mpaunete/rolo/electronics/rolo.step

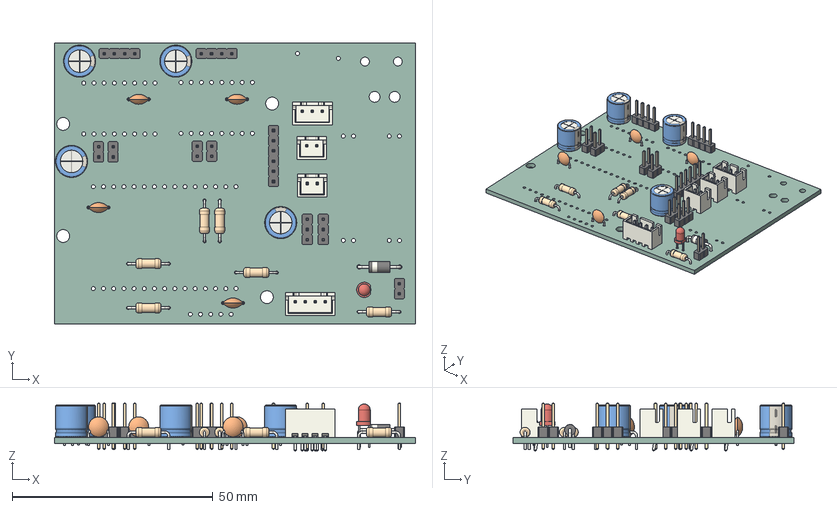
[picture p5: CAD file, 2026-10-27]
electronics/rolo.step
90.0 x 70.0 x 11.9 mm
R_Axial_DIN0207_L63mm_D25mm_P1016mm_Horizontal x 6
C_Disc_D50mm_W25mm_P500mm x 4
PinHeader_1x04_P254mm_Vertical x 2
JST_B2B_XH_A x 2
PinHeader_1x03_P254mm_Vertical x 2
CP_Radial_D80mm_P350mm x 4
JST_B4B_XH_A
PinHeader_1x02_P254mm_Vertical x 5
LED_D3.0mm
PinHeader_1x06_P254mm_Vertical
JST_B3B_XH_A
D_DO-41_SOD81_P10.16mm_Horizontal
rolo-unsaved-export-d1h4hm_PCB
