mpaunete/rolo/electronics/rolo.kicad_pcb

## KiCad design electronics/rolo.kicad_pcb (2026-10-27)

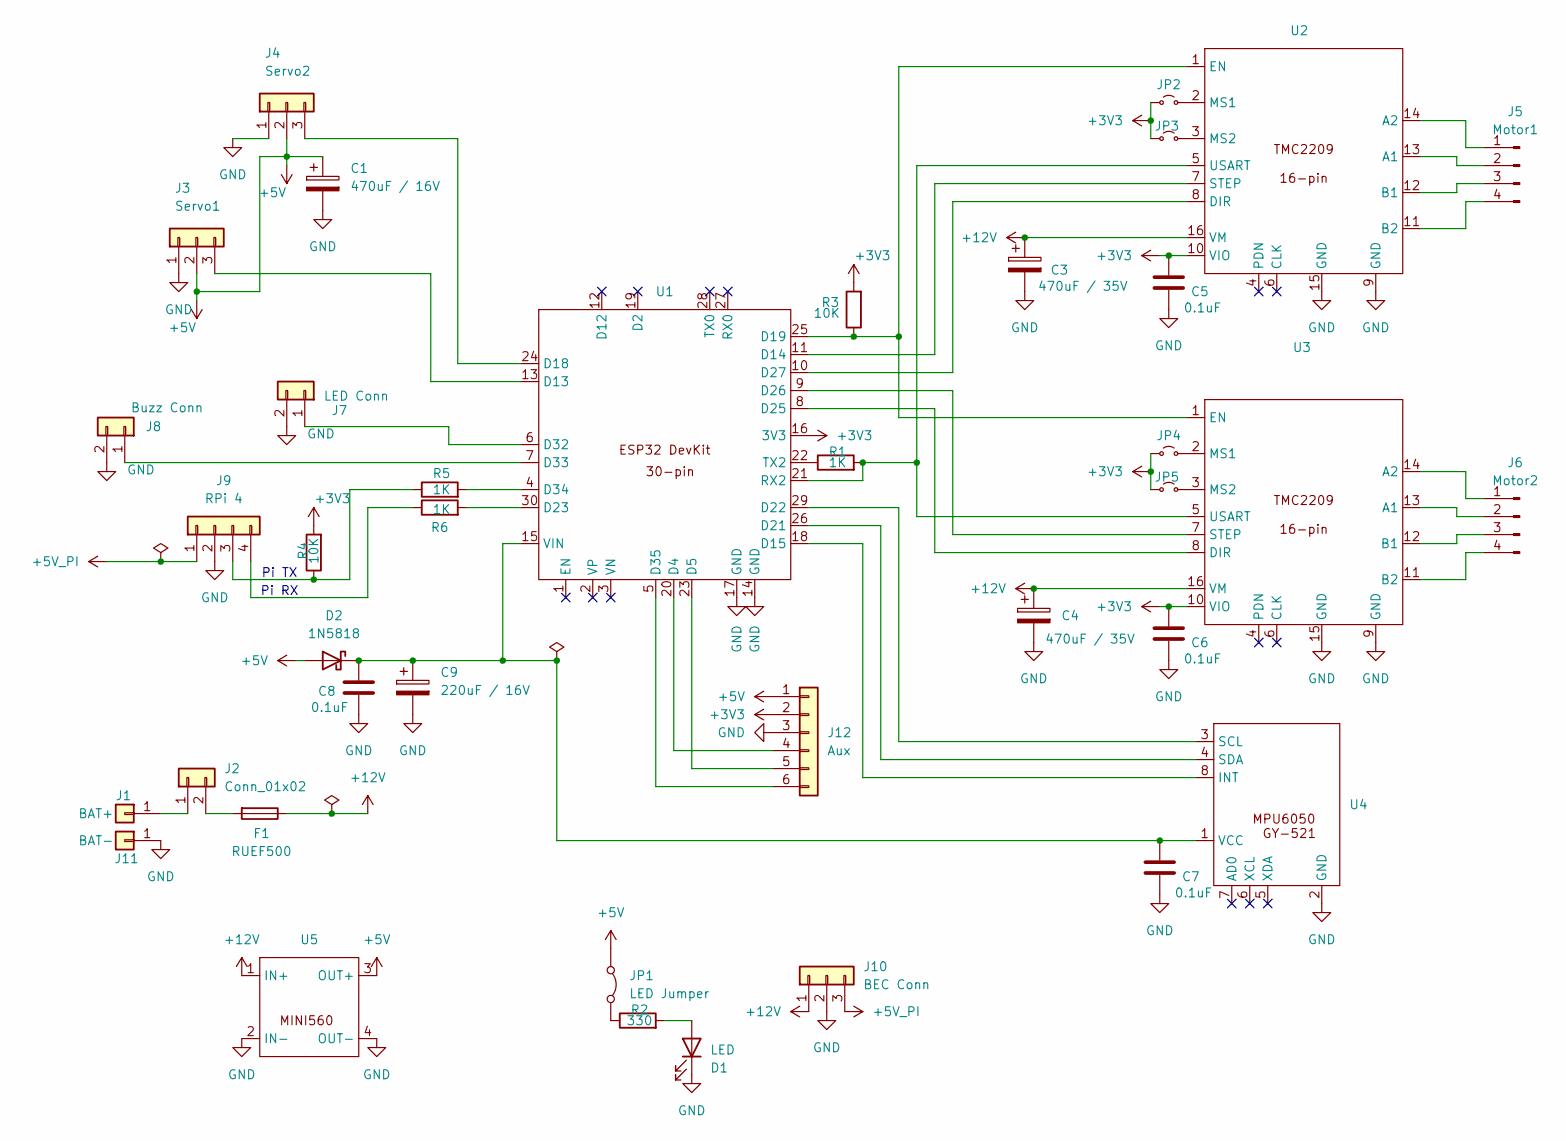
[picture p7: schematic rolo.kicad_sch]

Parts:
C1: 470uF / 16V; CP_Radial_D8.0mm_P3.50mm
C3, C4: 470uF / 35V; CP_Radial_D8.0mm_P3.50mm
C5, C6, C7, C8: 0.1uF; C_Disc_D5.0mm_W2.5mm_P5.00mm
C9: 220uF / 16V; CP_Radial_D8.0mm_P3.50mm
D1: LED; LED_D3.0mm
D2: 1N5818; D_DO-41_SOD81_P10.16mm_Horizontal
F1: RUEF500; Fuse_RUEF500
J1: BAT+; MountingHole_2.2mm_M2_Pad
J2: Conn_01x02; AMASS_XT30U-M_1x02_P5.0mm_Vertical
J3: Servo1; PinHeader_1x03_P2.54mm_Vertical
J4: Servo2; PinHeader_1x03_P2.54mm_Vertical
J5: Motor1; PinHeader_1x04_P2.54mm_Vertical
J6: Motor2; PinHeader_1x04_P2.54mm_Vertical
J7: LED Conn; JST_XH_B2B-XH-A_1x02_P2.50mm_Vertical
J8: Buzz Conn; JST_XH_B2B-XH-A_1x02_P2.50mm_Vertical
J9: RPi 4; JST_XH_B4B-XH-A_1x04_P2.50mm_Vertical
J10: BEC Conn; JST_XH_B3B-XH-A_1x03_P2.50mm_Vertical
J11: BAT-; MountingHole_2.2mm_M2_Pad
J12: Aux; PinHeader_1x06_P2.54mm_Vertical
JP1: LED Jumper; PinHeader_1x02_P2.54mm_Vertical
JP2, JP4: MS1 EN; PinHeader_1x02_P2.54mm_Vertical
JP3, JP5: MS2 EN; PinHeader_1x02_P2.54mm_Vertical
R1, R5, R6: 1K; R_Axial_DIN0207_L6.3mm_D2.5mm_P10.16mm_Horizontal
R2: 330; R_Axial_DIN0207_L6.3mm_D2.5mm_P10.16mm_Horizontal
R3, R4: 10K; R_Axial_DIN0207_L6.3mm_D2.5mm_P10.16mm_Horizontal
U1: ESP32_DevKit_30Pin
U2, U3: TMC2209_16Pin
U4: MPU6050_Conn
U5: MINI560_5V_8Pin

Connections:
+3V3: C5.1, C6.1, J12.2, JP2.1 (A), JP3.1 (A), JP4.1 (A), JP5.1 (A), R3.2, R4.2, U1.16 (3V3), U2.10 (VIO), U3.10 (VIO)
+5V: C1.1, D2.2 (A), J3.2, J4.2, J12.1, JP1.1 (A), U5.3 (OUT+)
+5V_PI: J9.1, J10.3
+12V: C3.1, C4.1, F1.1, J10.1, U2.16 (VM), U3.16 (VM), U5.1 (IN+)
GND: C1.2, C3.2, C4.2, C5.2, C6.2, C7.2, C8.2, C9.2, D1.1 (K), J3.1, J4.1, J7.2, J8.2, J9.2, J10.2, J11.1 (Pin_1_1), J12.3, U1.14 (GND), U1.17 (GND), U2.9 (GND), U2.15 (GND), U3.9 (GND), U3.15 (GND), U4.2 (GND), U5.2 (IN-), U5.4 (OUT-)
unnamed: D1.2 (A), R2.2
unnamed: C7.1, C8.1, C9.1, D2.1 (K), U1.15 (VIN), U4.1 (VCC)
unnamed: J1.1 (Pin_1_1), J2.1
unnamed: F1.2, J2.2
unnamed: J3.3, U1.13 (D13)
unnamed: J4.3, U1.24 (D18)
unnamed: J5.1, U2.14 (A2)
unnamed: J5.2, U2.13 (A1)
unnamed: J5.3, U2.12 (B1)
unnamed: J5.4, U2.11 (B2)
unnamed: J6.1, U3.14 (A2)
unnamed: J6.2, U3.13 (A1)
unnamed: J6.3, U3.12 (B1)
unnamed: J6.4, U3.11 (B2)
unnamed: J7.1, U1.6 (D32)
unnamed: J8.1, U1.7 (D33)
unnamed: J9.3, R4.1, R5.1
unnamed: J9.4, R6.1
unnamed: J12.4, U1.20 (D4)
unnamed: J12.5, U1.23 (D5)
unnamed: J12.6, U1.5 (D35)
unnamed: JP1.2 (B), R2.1
unnamed: JP2.2 (B), U2.2 (MS1)
unnamed: JP3.2 (B), U2.3 (MS2)
unnamed: JP4.2 (B), U3.2 (MS1)
unnamed: JP5.2 (B), U3.3 (MS2)
unnamed: U1.11 (D14), U2.7 (STEP)
unnamed: U1.18 (D15), U4.8 (INT)
unnamed: R3.1, U1.25 (D19), U2.1 (EN), U3.1 (EN)
unnamed: U1.26 (D21), U4.4 (SDA)
unnamed: U1.29 (D22), U4.3 (SCL)
unnamed: R6.2, U1.30 (D23)
unnamed: U1.8 (D25), U3.8 (DIR)
unnamed: U1.9 (D26), U3.7 (STEP)
unnamed: U1.10 (D27), U2.8 (DIR)
unnamed: R5.2, U1.4 (D34)
unnamed: R1.2, U1.21 (RX2), U2.5 (USART), U3.5 (USART)
unnamed: R1.1, U1.22 (TX2)

Notes on the sheet:
Pi TX
Pi RX

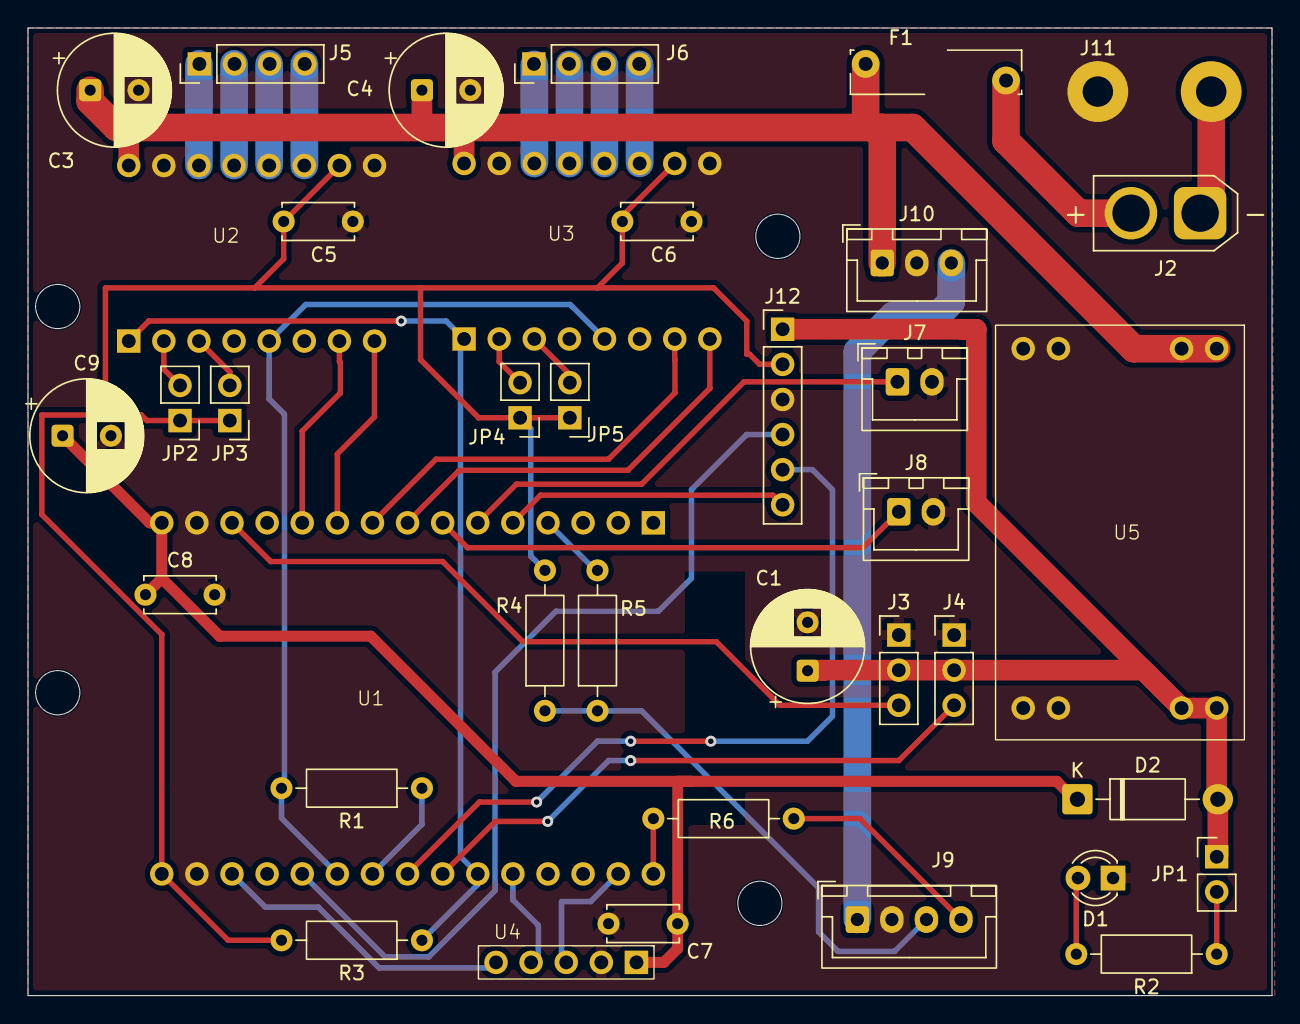
[picture p8: board rolo.kicad_pcb from above]

Board: 2 copper layers, 90.0 x 70.0 mm, 39 parts (1 on the bottom side), 43 nets.
